h2o-robotics/buoys-ping/Enclosure/Sujeccion_PCBs - v2.stl

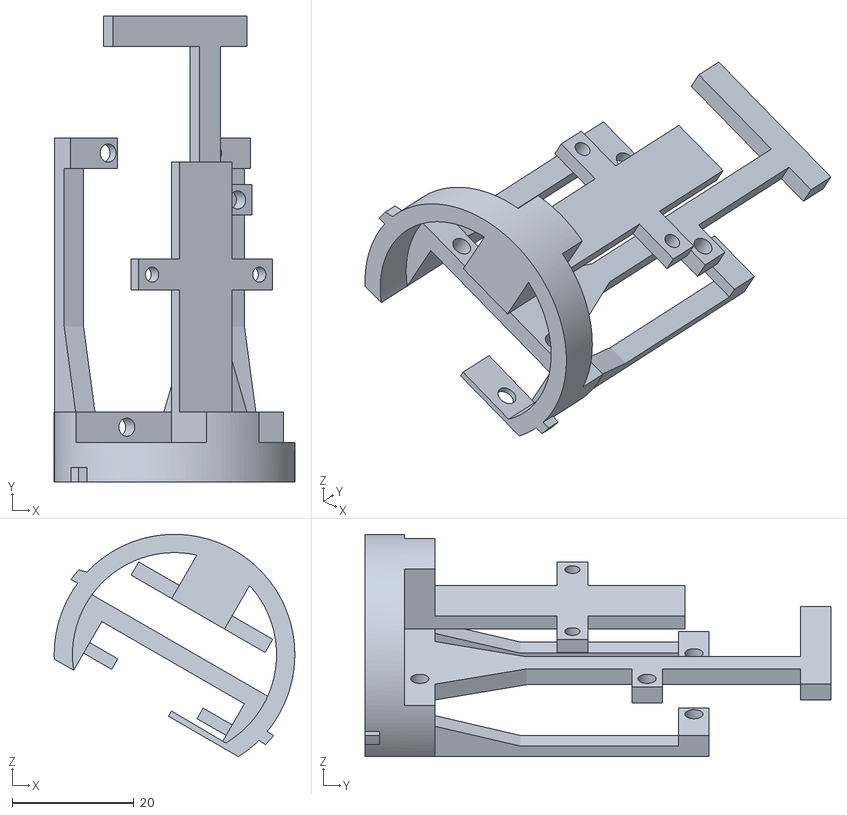
[picture p19: CAD file, 2023-11-02]
Enclosure/Sujeccion_PCBs - v2.stl
39.5 x 76.5 x 36.5
