h2o-robotics/buoys-ping/(list of files, cad)

Other CAD files:
Enclosure/Batería.ipt
Enclosure/Cilindro_hueco.ipt
Enclosure/Cuerpo_interruptor_BlueRobotics.ipt
Enclosure/ESP32.ipt
Enclosure/Ensamblaje carcasa - v2.iam
Enclosure/Ensamblaje carcasa.iam
Enclosure/GPS.ipt
Enclosure/Interruptor_BlueRobotics.ipt
Enclosure/Junta_torica_pieza_sonar.ipt
Enclosure/Junta_torica_sonar.ipt
Enclosure/Nano-modem.ipt
Enclosure/Nordic_PCB.ipt
Enclosure/OldVersions/Cilindro_hueco.0001.ipt
Enclosure/OldVersions/Cuerpo_interruptor_BlueRobotics.0001.ipt
Enclosure/OldVersions/Ensamblaje carcasa - v2.0010.iam
Enclosure/OldVersions/Ensamblaje carcasa.0006.iam
Enclosure/OldVersions/Junta_torica_sonar.0001.ipt
Enclosure/OldVersions/Pieza_conectores.0003.ipt
Enclosure/OldVersions/Sujeccion_PCBs - v2.0007.ipt
Enclosure/OldVersions/Sujeccion_PCBs.0002.ipt
Enclosure/OldVersions/Sujección_Baterias.0002.ipt
Enclosure/OldVersions/Tapon_interruptor_BlueRobotics.0002.ipt
Enclosure/OldVersions/Tuerca_interruptor_BlueRobotics.0003.ipt
Enclosure/OldVersions/Tuerca_pieza_conectores.0001.ipt
Enclosure/Pieza_conectores.ipt
Enclosure/Pieza_sonar.ipt
Enclosure/Sonar.ipt
Enclosure/Sujeccion_PCBs - v2.ipt
Enclosure/Sujeccion_PCBs.ipt
Enclosure/Sujección_Baterias.ipt
Enclosure/Sujección_piezas_sonar.ipt
Enclosure/Tapon_interruptor_BlueRobotics.ipt
Enclosure/Tuerca_interruptor_BlueRobotics.ipt
Enclosure/Tuerca_pieza_conectores.ipt
