h2o-robotics/buoys-ping/(commit log)

2022-07-29 1 coast, 1 master, multiple divers
    Communication between 1 coast board, 1 master buoy (and its 2 slaves) and multiple divers
2022-08-11 Improvement ThingsBoard
    The RNG data message sent from the coast board to TB is now sorted in a specific way. So it will always appear in the same order on the dsahboard, which makes the reading of the data easier.
2022-08-12 Entry of the WiFi AP
    The user can now directly enter, via the phone of the CU, the name and password of the WiFi AP they want the coast board to be connected on.
2022-10-18 Add modified coast board code for PingerApp
2023-09-13 Created new base in PlatformIO
    - old ArduinoIDE codebase was moved to the seprate folder "ArduinoIDE scripts"
    - new PlatfromIO project "buyos-ping" was created
    - base for the project was created, now all code is in one project and can be dynamically typed on device base (Master/Slave buoy, Coast board)
    TODO:
    - finish importing old scripts to project
    - rearrange code for better code-clarity
2023-10-13 "Coast board" ported to PlatformIO
    - complete coast board source is ported in
    - "config" scripts for LORA and WIFI are updated
2023-11-02 Merged recent working version
    Version created on summer of 2023 that has been tested is now pushed to main branch.
    [Batería.ipt, Cilindro_hueco.0001.ipt, Cilindro_hueco.ipt, Cuerpo_interruptor_BlueRobotics.0001.ipt, Cuerpo_interruptor_BlueRobotics.ipt, ESP32.ipt, Ensamblaje carcasa - v2.0010.iam, Ensamblaje carcasa - v2.iam]
2024-09-05 Restrucrture and visaulizer adition
    - Changed WIFI communication between the buoys to ESP-NOW
    - Fixed stability issues from before with data communication
    - Added ROS node implementation for visualizing the buoys location and distance and for displaying approximation of the diver location
    - Added final iteration of final thesis from Luka Bradarić Lisić (in Croatian)
    [CoastBoard.cpp, CoastBoard.h, Coast_board.ino, Esp_Now_config.cpp]
